podwan/balancer/document/remoter.jpg

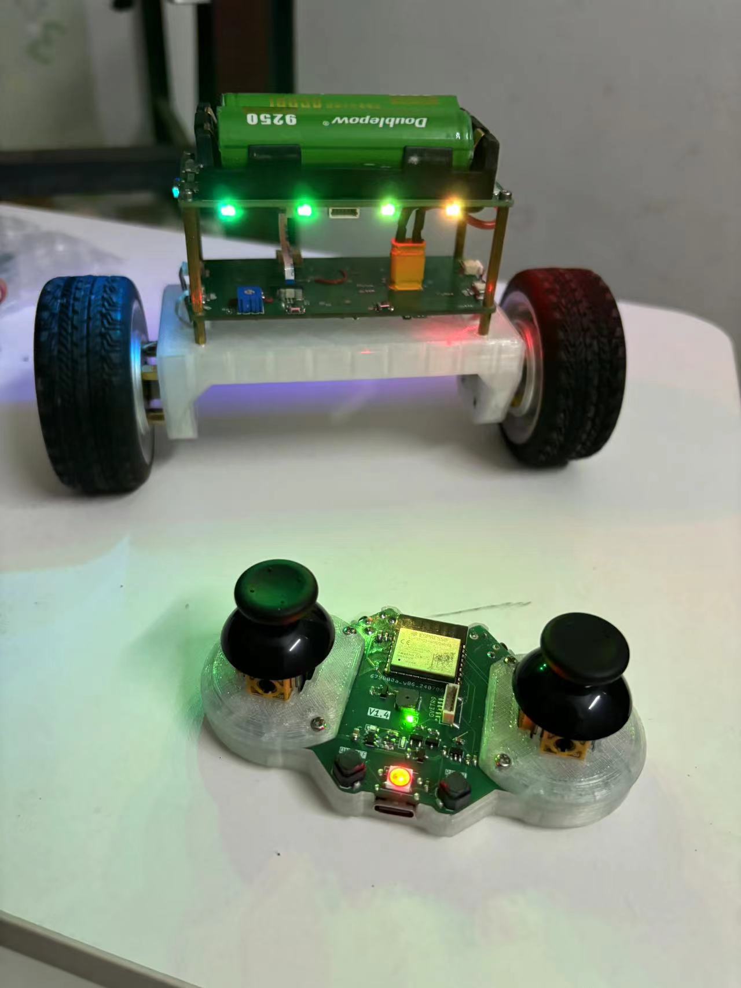
document/remoter.jpg
