podwan/balancer/document/balancer.jpg

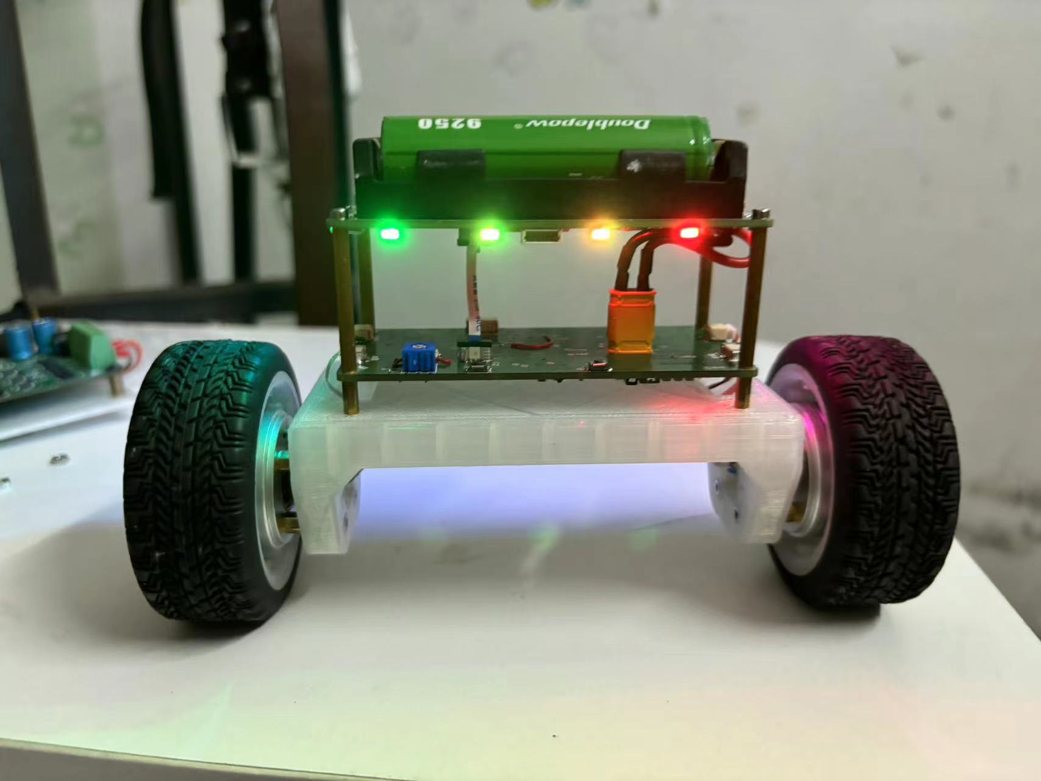
document/balancer.jpg
