podwan/balancer/document/stack.jpg

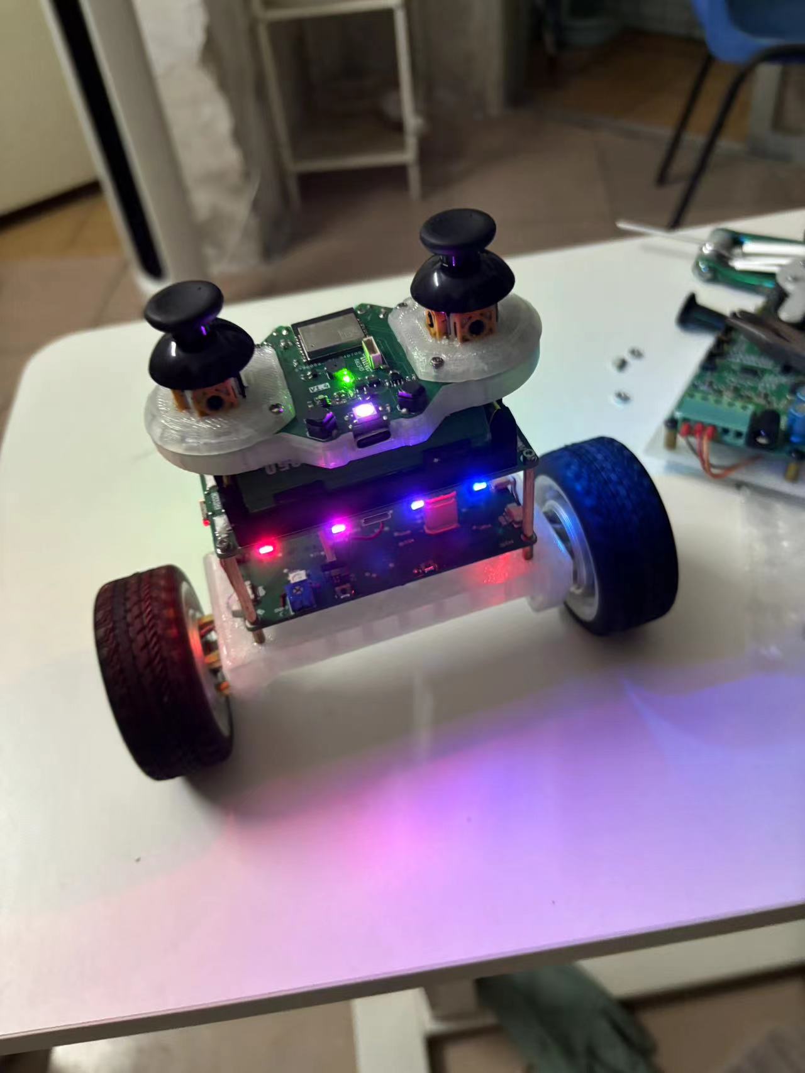
document/stack.jpg
