podwan/balancer/hardware/controller/3d/TS-1199A-B-B.stp

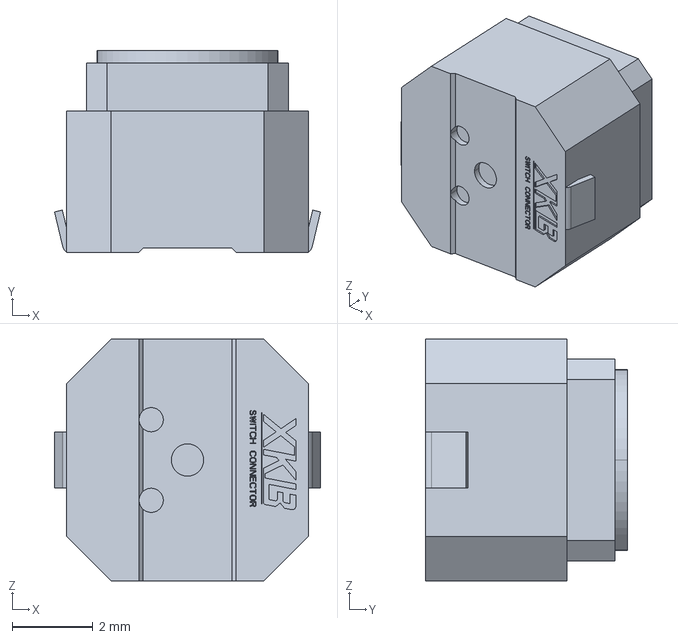
[picture p4: CAD file, 2024-05-17]
hardware/controller/3d/TS-1199A-B-B.stp
6.60 x 5.00 x 6.00 mm
