podwan/balancer/hardware/encoder/encoder_edge-Sketch.dxf

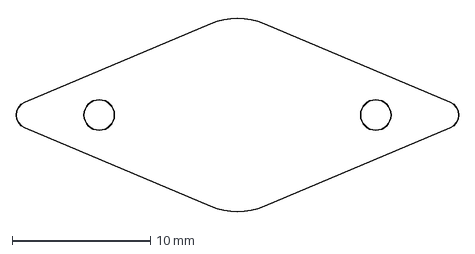
[picture p5: CAD file, 2024-05-17]
hardware/encoder/encoder_edge-Sketch.dxf
32.0 x 14.3 mm
