podwan/balancer/mechanic/wheel v10.stl

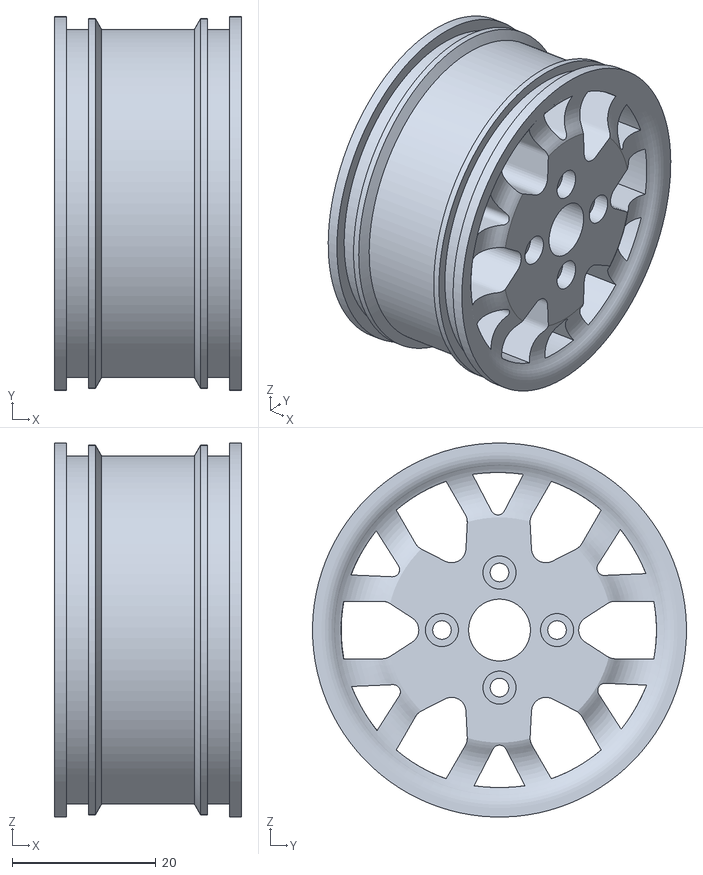
[picture p8: CAD file, 2024-06-01]
mechanic/wheel v10.stl
26.0 x 52.0 x 52.0
