podwan/balancer/hardware/controller/3d/TC-1102N-C-AS-B.stp

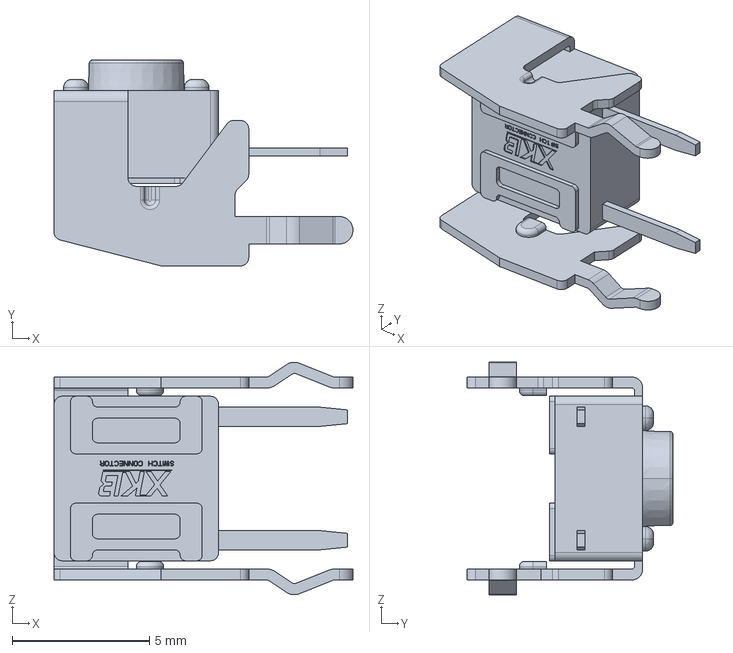
[picture p9: CAD file, 2024-05-17]
hardware/controller/3d/TC-1102N-C-AS-B.stp
10.9 x 7.50 x 8.48 mm
