podwan/balancer/hardware/encoder/encoder_edge.dxf

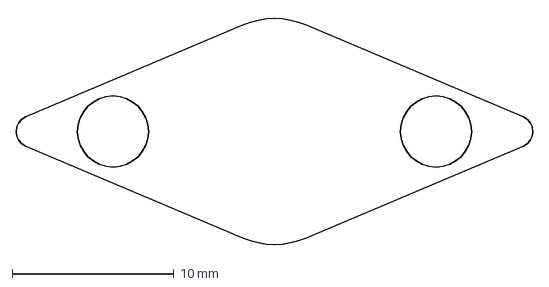
[picture p10: CAD file, 2024-05-17]
hardware/encoder/encoder_edge.dxf
32.0 x 14.3 mm
