podwan/balancer/mechanic/balancer v20.stl

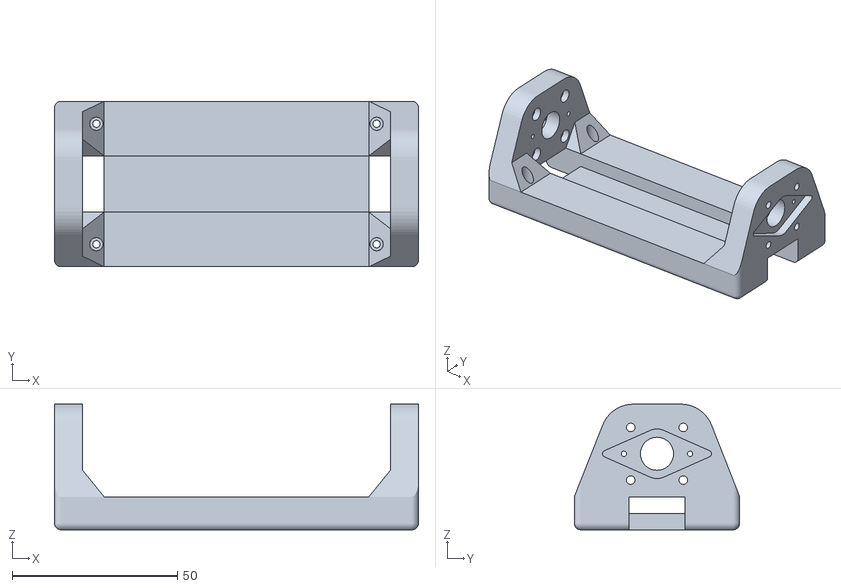
[picture p11: CAD file, 2024-06-01]
mechanic/balancer v20.stl
110.0 x 50.0 x 38.0
