podwan/balancer/mechanic/磁铁固定件.stl

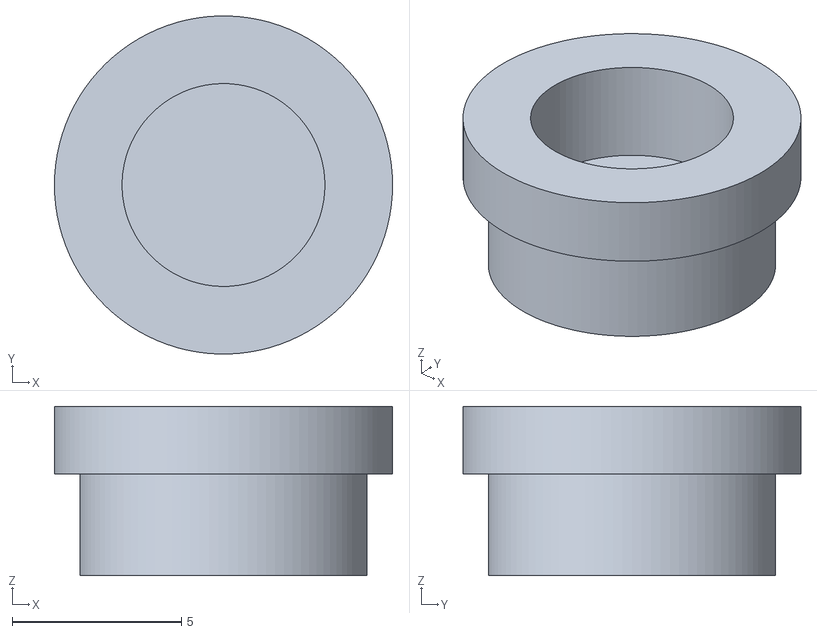
[picture p12: CAD file, 2024-05-17]
mechanic/磁铁固定件.stl
10.0 x 10.00 x 5.00
