podwan/balancer/hardware/motor/model/TPS61088RHLR.STEP

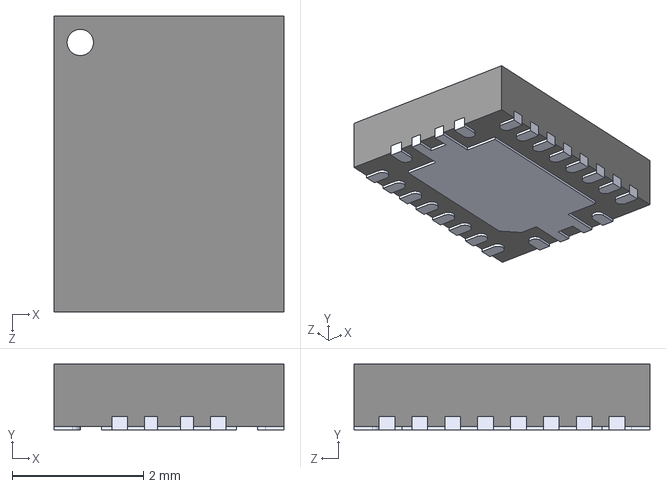
[picture p13: CAD file, 2023-12-19]
hardware/motor/model/TPS61088RHLR.STEP
3.50 x 1.00 x 4.50 mm
