podwan/balancer/(list of files, cad)

Other CAD files:
mechanic/encoder_edge.FCStd
