podwan/balancer/firmware/motorDriver/motorDriver.ioc

Mcu.UserName=STM32G431CBUx
PA1.Signal=ADC1_IN2
PA10.Signal=S_TIM1_CH3
PA11.GPIO_Label=TEST
PA11.Signal=GPIO_Output
PA13.Signal=SYS_JTMS-SWDIO
PA14.Signal=SYS_JTCK-SWCLK
PA2.Signal=USART2_TX
PA3.Signal=USART2_RX
PA4.GPIO_Label=SPI1_CS
PA4.Signal=GPIO_Output
PA5.Signal=SPI1_SCK
PA6.Signal=SPI1_MISO
PA7.Signal=SPI1_MOSI
PA8.Signal=S_TIM1_CH1
PA9.Signal=S_TIM1_CH2
PB0.Signal=SharedAnalog_PB0
PB1.Signal=SharedAnalog_PB1
PB10.Signal=USART3_TX
PB11.Signal=USART3_RX
PB12.Signal=ADC1_IN11
PB14.Signal=ADC1_IN5
PB15.Signal=ADC2_IN15
PB2.Signal=ADC2_IN12
PB3.GPIO_Label=NSS1
PB3.Signal=GPIO_Output
PB5.Signal=SPI3_MOSI
PB6.Signal=S_TIM8_CH1
PB8-BOOT0.Signal=S_TIM8_CH2
PB9.Signal=S_TIM8_CH3
PC10.Signal=SPI3_SCK
PC11.Signal=SPI3_MISO
PC13.Signal=GPIO_Input
PC14-OSC32_IN.GPIO_Label=KEY
PC14-OSC32_IN.Signal=GPIO_Input
PC4.GPIO_Label=NSS2
PC4.Signal=GPIO_Output
PF0-OSC_IN.Signal=RCC_OSC_IN
PF1-OSC_OUT.Signal=RCC_OSC_OUT
