podwan/balancer/firmware/motorDriver/FocLib/bldcMotor.c

#include "bldcMotor.h"
#include "math_utils.h"
#include "voltage.h"
#include "current.h"
#include "encoder.h"
#include "pid.h"
#include "lowpass_filter.h"
#include "focLib.h"

void goToZeroElecAngle(BldcMotor *motor)
{
    setTorque(motor, 0, OPEN_LOOP_TORQUE, 0);
    delay(700);
}
int alignSensor(BldcMotor *motor)
{
    // setTorque(motor, OPEN_LOOP_TORQUE, 0, _3PI_2);
    // delay(200);
    // encoderUpdate(&motor->magEncoder);
    // float start_angle = motor->magEncoder.fullAngle;
    // printLog("start_angle:%f\n", start_angle);
    for (int i = 0; i <= 500; i++)
    {
        float angle = _3PI_2 + _2PI * i / 500.0f;
        setTorque(motor, OPEN_LOOP_TORQUE, 0, angle);
        encoderUpdate(&motor->magEncoder);
        delay(2);
    }
    // encoderUpdate(&motor->magEncoder);

    float mid_angle = motor->magEncoder.fullAngle;
    printLog("mid_angle:%f\n", mid_angle);
    // move one electrical revolution backwards
    for (int i = 500; i >= 0; i--)
    {
        float angle = _3PI_2 + _2PI * i / 500.0f;
        setTorque(motor, OPEN_LOOP_TORQUE, 0, angle);
        encoderUpdate(&motor->magEncoder);
        delay(2);
    }
    // encoderUpdate(&motor->magEncoder);

    float end_angle = motor->magEncoder.fullAngle;
    printLog("end_angle:%f\n", end_angle);
    // setPhaseVoltage(0, 0, 0);
    delay(200);

    // determine the direction the sensor moved
    float moved = fabsf(mid_angle - end_angle);
    printLog("moved:%f\n", moved);
    if (moved < MIN_ANGLE_DETECT_MOVEMENT)
    { // minimum angle to detect movement
        printLog("Failed to notice movement\n");
        return 0; // failed calibration
    }
    else if (mid_angle < end_angle)
    {
        printLog("sensor_direction==CCW\n");
        motor->magEncoder.direction = CCW;
    }
    else
    {
        printLog("sensor_direction==CW\n");
        motor->magEncoder.direction = CW;
    }
    // check pole pair number
    bool pp_check_result = !(fabsf(moved * motor->pole_pairs - _2PI) > 0.5f); // 0.5f is arbitrary number it can be lower or higher!
    if (pp_check_result == false)
    {
        printLog("PP check: fail - estimated pp: %d\n", (int)(_2PI / moved));
    }
    else
    {
        printLog("PP check: OK!\n");
    }

    // align the electrical phases of the motor and sensor
    // set angle -90(270 = 3PI/2) degrees
    goToZeroElecAngle(motor);
    // read the sensor
    encoderUpdate(&motor->magEncoder);
    // get the current zero electric angle
    motor->zeroElectricAngleOffSet = 0;
    getElecAngle(motor);
    motor->zeroElectricAngleOffSet = motor->angle_el;
    // zero_electric_angle =  _normalizeAngle(_electricalAngle(sensor_direction*sensor->getAngle(), pole_pairs));

    // encoderUpdate(&motor->magEncoder);
    getElecAngle(motor);
    // motor->zeroElectricAngleOffSet = 0;
    // printLog("[zeroAngleOffset]:%f  [zeroAngle]:%f\r\n", motor->zeroElectricAngleOffSet, motor->angle_el);
    printLog("[zeroAngleOffset]:%f\n", motor->zeroElectricAngleOffSet);
    printLog("[zeroAngle]:%f\n", motor->angle_el);
    // // make sure the angle_el is about zero

    // delay(200);
}

void getElecAngle(BldcMotor *motor)
{
    motor->angle_el = _normalizeAngle(motor->pole_pairs * motor->magEncoder.shaftAngle - motor->zeroElectricAngleOffSet);
}

void foc(BldcMotor *motor, uint32_t adc_a, uint32_t adc_b)
{

    if (motor->state == MOTOR_CALIBRATE)
    {
        getCurrentOffsets(motor, adc_a, adc_b, 100);
        alignSensor(motor);
        motor->state = MOTOR_READY;
        motor->stopPwm();
    }
    else
    {

        float IqRef, velocityRef;
        float velocityErr, angleErr;

        getPhaseCurrents(motor, adc_a, adc_b);
        getABCurrents(motor);
        getDQCurrents(motor);
        motor->Iq = lpfOperator(&motor->IqFilter, motor->Iq);
        motor->Id = lpfOperator(&motor->IdFilter, motor->Id);
        encoderUpdate(&motor->magEncoder);
        motor->magEncoder.velocity = lpfOperator(&motor->velocityFilter, motor->magEncoder.velocity);

        getElecAngle(motor);

        if (motor->state == MOTOR_READY)
        {
        }
        else if (motor->state == MOTOR_START)
        {

            switch (motor->controlType)
            {
            case VELOCITY_OPEN_LOOP:
                // 用于验证setTorque（SVPWM马鞍波)函数、编码器测速（方向）及相电流采样（正弦波）的验证，
                // 避免长时间运行（发热）
                static float shaftAngle;
                motor->target = 50;
                shaftAngle = _normalizeAngle(shaftAngle + motor->target * motor->Ts);
                motor->angle_el = _electricalAngle(shaftAngle, motor->pole_pairs);
                motor->Uq = OPEN_LOOP_TORQUE;
                break;
            case TORQUE:

                if (motor->torqueType == VOLTAGE)
                {
                    // motor->target = UqMAX;
                    motor->Uq = motor->target;
                }
                else
                {
                    // motor->target = 0;
                    motor->Ud = pidOperator(&motor->pidId, 0 - motor->Id);
                    motor->Uq = pidOperator(&motor->pidIq, motor->target - motor->Iq);
                }
                break;

            case VELOCITY:
                if (motor->torqueType == VOLTAGE)
                {
                    // motor->target = 190;
                    velocityErr = motor->target - motor->magEncoder.velocity;
                    motor->Uq = pidOperator(&motor->velocityPID, velocityErr);
                }
                else
                {
                    velocityErr = motor->target - motor->magEncoder.velocity;
                    IqRef = pidOperator(&motor->velocityPID, velocityErr);

                    motor->Ud = pidOperator(&motor->pidId, 0 - motor->Id);
                    motor->Uq = pidOperator(&motor->pidIq, IqRef - motor->Iq);
                }
                break;

            case ANGLE:
                if (motor->torqueType == VOLTAGE)
                {
                    angleErr = motor->target - motor->magEncoder.fullAngle;
                    motor->Uq = pidOperator(&motor->anglePID, angleErr);
                }
                else
                {
                    angleErr = motor->target - motor->magEncoder.fullAngle;
                    velocityRef = pidOperator(&motor->anglePID, angleErr);
                    IqRef = pidOperator(&motor->velocityPID, velocityRef - motor->magEncoder.velocity);
                    // IqRef = pidOperator(&motor->anglePID, angleErr);
                    motor->Ud = pidOperator(&motor->pidId, 0 - motor->Id);
                    motor->Uq = pidOperator(&motor->pidIq, IqRef - motor->Iq);
                }
                break;
            }
            setTorque(motor, motor->Uq, motor->Ud, motor->angle_el);
        }
    }
}
