podwan/balancer/firmware/motorDriver/Core/Src/main.c

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
/* Includes ------------------------------------------------------------------*/
#include "main.h"
#include "adc.h"
#include "comp.h"
#include "dac.h"
#include "dma.h"
#include "spi.h"
#include "tim.h"
#include "usart.h"
#include "gpio.h"

/* USER CODE BEGIN Includes */
#include "comm.h"
#include "userMain.h"
#include "app.h"
/* USER CODE END Includes */


void SystemClock_Config(void);
/* USER CODE BEGIN 0 */
extern DMA_HandleTypeDef hdma_usart2_rx;
extern DMA_HandleTypeDef hdma_usart3_rx;
/* USER CODE END 0 */

/**
  * @brief  The application entry point.
  * @retval int
  */
int main(void)
{

  /* MCU Configuration--------------------------------------------------------*/

  /* Reset of all peripherals, Initializes the Flash interface and the Systick. */
  HAL_Init();

  /* Configure the system clock */
  SystemClock_Config();

  /* Initialize all configured peripherals */
  MX_GPIO_Init();
  MX_DMA_Init();
  MX_USART3_UART_Init();
  MX_ADC1_Init();
  MX_ADC2_Init();
  MX_TIM1_Init();
  MX_DAC3_Init();
  MX_SPI1_Init();
  MX_TIM8_Init();
  MX_SPI3_Init();
  MX_USART2_UART_Init();
  MX_COMP1_Init();
  MX_COMP4_Init();
  /* USER CODE BEGIN 2 */
  appInit();
#if 1
  HAL_UARTEx_ReceiveToIdle_DMA(&huart2, rxBuffer, sizeof(rxBuffer));
  __HAL_DMA_DISABLE_IT(&hdma_usart2_rx, DMA_IT_HT);
  HAL_UARTEx_ReceiveToIdle_DMA(&huart3, rxBuffer, sizeof(rxBuffer));
  __HAL_DMA_DISABLE_IT(&hdma_usart3_rx, DMA_IT_HT);
  // HAL_UARTEx_ReceiveToIdle_DMA(&huart3, rxBuffer, sizeof(rxBuffer));
  HAL_ADCEx_Calibration_Start(&hadc1, ADC_SINGLE_ENDED);
  HAL_ADCEx_Calibration_Start(&hadc2, ADC_SINGLE_ENDED);
  __HAL_ADC_CLEAR_FLAG(&hadc1, ADC_FLAG_JEOC);
  __HAL_ADC_CLEAR_FLAG(&hadc1, ADC_FLAG_EOC);
  __HAL_ADC_CLEAR_FLAG(&hadc2, ADC_FLAG_JEOC);

  HAL_DAC_SetValue(&hdac3, DAC_CHANNEL_1, DAC_ALIGN_12B_R, 2300);
  HAL_DAC_Start(&hdac3, DAC_CHANNEL_1);
  HAL_COMP_Start(&hcomp1);

  HAL_DAC_SetValue(&hdac3, DAC_CHANNEL_2, DAC_ALIGN_12B_R, 2300);
  HAL_DAC_Start(&hdac3, DAC_CHANNEL_2);
  HAL_COMP_Start(&hcomp4);

  HAL_ADCEx_InjectedStart_IT(&hadc1);
  HAL_ADCEx_InjectedStart(&hadc2);

  HAL_TIM_Base_Start(&htim8);
  HAL_TIM_PWM_Start(&htim8, TIM_CHANNEL_4);
  HAL_TIM_PWM_Start(&htim8, TIM_CHANNEL_1);
  HAL_TIM_PWM_Start(&htim8, TIM_CHANNEL_2);
  HAL_TIM_PWM_Start(&htim8, TIM_CHANNEL_3);

  HAL_TIM_Base_Start(&htim1);
  HAL_TIM_PWM_Start(&htim1, TIM_CHANNEL_4);
  HAL_TIM_PWM_Start(&htim1, TIM_CHANNEL_1);
  HAL_TIM_PWM_Start(&htim1, TIM_CHANNEL_2);
  HAL_TIM_PWM_Start(&htim1, TIM_CHANNEL_3);
#endif
  /* USER CODE END 2 */

  /* Infinite loop */
  /* USER CODE BEGIN WHILE */
  while (1)
  {
    /* USER CODE END WHILE */

    /* USER CODE BEGIN 3 */
    userMain();
  }
  /* USER CODE END 3 */
}

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
