podwan/balancer/firmware/espBat/BLE_client/BLE_client.ino

/**
 * A BLE client example that is rich in capabilities.
 * There is a lot new capabilities implemented.
 * author unknown
 * updated by chegewara
 */

#include "BLEDevice.h"
#include "driver/uart.h"
//#include "BLEScan.h"
HardwareSerial serial1(1);
// The remote service we wish to connect to.
static BLEUUID serviceUUID("6E400001-B5A3-F393-E0A9-E50E24DCCA9E");
// The characteristic of the remote service we are interested in.
static BLEUUID charUUID("6E400003-B5A3-F393-E0A9-E50E24DCCA9E");

static boolean doConnect = false;
static boolean connected = false;
static boolean doScan = false;
static BLERemoteCharacteristic* pRemoteCharacteristic;
static BLEAdvertisedDevice* myDevice;

static void notifyCallback(
  BLERemoteCharacteristic* pBLERemoteCharacteristic,
  uint8_t* pData,
  size_t length,
  bool isNotify) {
  Serial1.print("Notify callback for characteristic ");
  Serial1.print(pBLERemoteCharacteristic->getUUID().toString().c_str());
  Serial1.print(" of data length ");
  Serial1.println(length);
  Serial1.print("data: ");
  Serial1.write(pData, length);
  Serial1.println();
}

class MyClientCallback : public BLEClientCallbacks {
  void onConnect(BLEClient* pclient) {
  }

  void onDisconnect(BLEClient* pclient) {
    connected = false;
    Serial1.println("onDisconnect");
  }
};

bool connectToServer() {
  Serial1.print("Forming a connection to ");
  Serial1.println(myDevice->getAddress().toString().c_str());

  BLEClient* pClient = BLEDevice::createClient();
  Serial1.println(" - Created client");

  pClient->setClientCallbacks(new MyClientCallback());

  // Connect to the remove BLE Server.
  pClient->connect(myDevice);  // if you pass BLEAdvertisedDevice instead of address, it will be recognized type of peer device address (public or private)
  Serial1.println(" - Connected to server");
  pClient->setMTU(517);  //set client to request maximum MTU from server (default is 23 otherwise)

  // Obtain a reference to the service we are after in the remote BLE server.
  BLERemoteService* pRemoteService = pClient->getService(serviceUUID);
  if (pRemoteService == nullptr) {
    Serial1.print("Failed to find our service UUID: ");
    Serial1.println(serviceUUID.toString().c_str());
    pClient->disconnect();
    return false;
  }
  Serial1.println(" - Found our service");


  // Obtain a reference to the characteristic in the service of the remote BLE server.
  pRemoteCharacteristic = pRemoteService->getCharacteristic(charUUID);
  if (pRemoteCharacteristic == nullptr) {
    Serial1.print("Failed to find our characteristic UUID: ");
    Serial1.println(charUUID.toString().c_str());
    pClient->disconnect();
    return false;
  }
  Serial1.println(" - Found our characteristic");

  // Read the value of the characteristic.pRemoteCharacteristic
  if (pRemoteCharacteristic->canRead()) {
    std::string value = pRemoteCharacteristic->readValue();
    Serial1.print("The characteristic value was: ");
    Serial1.println(value.c_str());
  }

  if (pRemoteCharacteristic->canNotify())
    pRemoteCharacteristic->registerForNotify(notifyCallback);

  connected = true;
  return true;
}
/**
 * Scan for BLE servers and find the first one that advertises the service we are looking for.
 */
class MyAdvertisedDeviceCallbacks : public BLEAdvertisedDeviceCallbacks {
  /**
   * Called for each advertising BLE server.
   */
  void onResult(BLEAdvertisedDevice advertisedDevice) {
    Serial1.print("BLE Advertised Device found: ");
    Serial1.println(advertisedDevice.toString().c_str());

    // We have found a device, let us now see if it contains the service we are looking for.
    if (advertisedDevice.haveServiceUUID() && advertisedDevice.isAdvertisingService(serviceUUID)) {

      BLEDevice::getScan()->stop();
      myDevice = new BLEAdvertisedDevice(advertisedDevice);
      doConnect = true;
      doScan = true;

    }  // Found our server
  }    // onResult
};     // MyAdvertisedDeviceCallbacks


void setup() {
  serial1.begin(115200, SERIAL_8N1, 20, 21);
  Serial1.println("Starting Arduino BLE Client application...");
  BLEDevice::init("");

  // Retrieve a Scanner and set the callback we want to use to be informed when we
  // have detected a new device.  Specify that we want active scanning and start the
  // scan to run for 5 seconds.
  BLEScan* pBLEScan = BLEDevice::getScan();
  pBLEScan->setAdvertisedDeviceCallbacks(new MyAdvertisedDeviceCallbacks());
  pBLEScan->setInterval(1349);
  pBLEScan->setWindow(449);
  pBLEScan->setActiveScan(true);
  pBLEScan->start(5, false);
}  // End of setup.


// This is the Arduino main loop function.
void loop() {

  // If the flag "doConnect" is true then we have scanned for and found the desired
  // BLE Server with which we wish to connect.  Now we connect to it.  Once we are
  // connected we set the connected flag to be true.
  if (doConnect == true) {
    if (connectToServer()) {
      Serial1.println("We are now connected to the BLE Server.");
    } else {
      Serial1.println("We have failed to connect to the server; there is nothin more we will do.");
    }
    doConnect = false;
  }

  // If we are connected to a peer BLE Server, update the characteristic each time we are reached
  // with the current time since boot.
  if (connected) {
    String newValue = "Time since boot: " + String(millis() / 1000);
    Serial1.println("Setting new characteristic value to \"" + newValue + "\"");

    // Set the characteristic's value to be the array of bytes that is actually a string.
    pRemoteCharacteristic->writeValue(newValue.c_str(), newValue.length());
  } else if (doScan) {
    BLEDevice::getScan()->start(0);  // this is just example to start scan after disconnect, most likely there is better way to do it in arduino
  }

  delay(1000);  // Delay a second between loops.
}  // End of loop
