podwan/balancer/firmware/motorDriver/User/pwm.c

#include "pwm.h"

 void startPwm1()
{
    HAL_TIM_PWM_Start(&htim8, TIM_CHANNEL_1);
    HAL_TIM_PWM_Start(&htim8, TIM_CHANNEL_2);
    HAL_TIM_PWM_Start(&htim8, TIM_CHANNEL_3);

}
 void stopPwm1()
{
    HAL_TIM_PWM_Stop(&htim8, TIM_CHANNEL_1);
    HAL_TIM_PWM_Stop(&htim8, TIM_CHANNEL_2);
    HAL_TIM_PWM_Stop(&htim8, TIM_CHANNEL_3);

}
 void updatePwm1(unsigned short int a, unsigned short int b, unsigned short int c)
{
    TIM8->CCR1 = a;
    TIM8->CCR2 = b;
    TIM8->CCR3 = c;
}

 void startPwm2()
{
    HAL_TIM_PWM_Start(&htim1, TIM_CHANNEL_1);
    HAL_TIM_PWM_Start(&htim1, TIM_CHANNEL_2);
    HAL_TIM_PWM_Start(&htim1, TIM_CHANNEL_3);
 
}
 void stopPwm2()
{
    HAL_TIM_PWM_Stop(&htim1, TIM_CHANNEL_1);
    HAL_TIM_PWM_Stop(&htim1, TIM_CHANNEL_2);
    HAL_TIM_PWM_Stop(&htim1, TIM_CHANNEL_3);
 
}

 void updatePwm2(unsigned short int a, unsigned short int b, unsigned short int c)
{
    TIM1->CCR1 = c;
    TIM1->CCR2 = b;
    TIM1->CCR3 = a;
}
