podwan/balancer/firmware/motorDriver/User/mpu6500.h

#ifndef BSP_SPI_H
#define BSP_SPI_H
#include "userMain.h"

uint8_t mpu_write_byte(uint8_t const reg, uint8_t const data);
void task(void);
// MPU6500初始数据结构体
typedef struct
{
    int16_t ax;
    int16_t ay;
    int16_t az;

    int16_t mx;
    int16_t my;
    int16_t mz;

    int16_t temp;

    int16_t gx;
    int16_t gy;
    int16_t gz;

    int16_t ax_offset;
    int16_t ay_offset;
    int16_t az_offset;

    int16_t gx_offset;
    int16_t gy_offset;
    int16_t gz_offset;
} mpu_data_t;

// 惯性测量单元数据结构体
typedef struct
{
    int16_t ax;
    int16_t ay;
    int16_t az;

    int16_t mx;
    int16_t my;
    int16_t mz;

    float temp;

    float wx; /*!< omiga, +- 2000dps => +-32768  so gx/16.384/57.3 =	rad/s */
    float wy;
    float wz;

    float vx;
    float vy;
    float vz;

    float rol;
    float pit;
    float yaw;
} imu_t;

extern mpu_data_t mpu_data;
extern imu_t imu;

// mpu地址
#define MPU6500_SELF_TEST_XG (0x00)
#define MPU6500_SELF_TEST_YG (0x01)
#define MPU6500_SELF_TEST_ZG (0x02)
#define MPU6500_SELF_TEST_XA (0x0D)
#define MPU6500_SELF_TEST_YA (0x0E)
#define MPU6500_SELF_TEST_ZA (0x0F)
#define MPU6500_XG_OFFSET_H (0x13)
#define MPU6500_XG_OFFSET_L (0x14)
#define MPU6500_YG_OFFSET_H (0x15)
#define MPU6500_YG_OFFSET_L (0x16)
#define MPU6500_ZG_OFFSET_H (0x17)
#define MPU6500_ZG_OFFSET_L (0x18)
#define MPU6500_SMPLRT_DIV (0x19)
#define MPU6500_CONFIG (0x1A)
#define MPU6500_GYRO_CONFIG (0x1B)
#define MPU6500_ACCEL_CONFIG (0x1C)
#define MPU6500_ACCEL_CONFIG_2 (0x1D)
#define MPU6500_LP_ACCEL_ODR (0x1E)
#define MPU6500_MOT_THR (0x1F)
#define MPU6500_FIFO_EN (0x23)
#define MPU6500_I2C_MST_CTRL (0x24)
#define MPU6500_I2C_SLV0_ADDR (0x25)
#define MPU6500_I2C_SLV0_REG (0x26)
#define MPU6500_I2C_SLV0_CTRL (0x27)
#define MPU6500_I2C_SLV1_ADDR (0x28)
#define MPU6500_I2C_SLV1_REG (0x29)
#define MPU6500_I2C_SLV1_CTRL (0x2A)
#define MPU6500_I2C_SLV2_ADDR (0x2B)
#define MPU6500_I2C_SLV2_REG (0x2C)
#define MPU6500_I2C_SLV2_CTRL (0x2D)
#define MPU6500_I2C_SLV3_ADDR (0x2E)
#define MPU6500_I2C_SLV3_REG (0x2F)
#define MPU6500_I2C_SLV3_CTRL (0x30)
#define MPU6500_I2C_SLV4_ADDR (0x31)
#define MPU6500_I2C_SLV4_REG (0x32)
#define MPU6500_I2C_SLV4_DO (0x33)
#define MPU6500_I2C_SLV4_CTRL (0x34)
#define MPU6500_I2C_SLV4_DI (0x35)
#define MPU6500_I2C_MST_STATUS (0x36)
#define MPU6500_INT_PIN_CFG (0x37)
#define MPU6500_INT_ENABLE (0x38)
#define MPU6500_INT_STATUS (0x3A)
#define MPU6500_ACCEL_XOUT_H (0x3B)
#define MPU6500_ACCEL_XOUT_L (0x3C)
#define MPU6500_ACCEL_YOUT_H (0x3D)
#define MPU6500_ACCEL_YOUT_L (0x3E)
#define MPU6500_ACCEL_ZOUT_H (0x3F)
#define MPU6500_ACCEL_ZOUT_L (0x40)
#define MPU6500_TEMP_OUT_H (0x41)
#define MPU6500_TEMP_OUT_L (0x42)
#define MPU6500_GYRO_XOUT_H (0x43)
#define MPU6500_GYRO_XOUT_L (0x44)
#define MPU6500_GYRO_YOUT_H (0x45)
#define MPU6500_GYRO_YOUT_L (0x46)
#define MPU6500_GYRO_ZOUT_H (0x47)
#define MPU6500_GYRO_ZOUT_L (0x48)
#define MPU6500_EXT_SENS_DATA_00 (0x49)
#define MPU6500_EXT_SENS_DATA_01 (0x4A)
#define MPU6500_EXT_SENS_DATA_02 (0x4B)
#define MPU6500_EXT_SENS_DATA_03 (0x4C)
#define MPU6500_EXT_SENS_DATA_04 (0x4D)
#define MPU6500_EXT_SENS_DATA_05 (0x4E)
#define MPU6500_EXT_SENS_DATA_06 (0x4F)
#define MPU6500_EXT_SENS_DATA_07 (0x50)
#define MPU6500_EXT_SENS_DATA_08 (0x51)
#define MPU6500_EXT_SENS_DATA_09 (0x52)
#define MPU6500_EXT_SENS_DATA_10 (0x53)
#define MPU6500_EXT_SENS_DATA_11 (0x54)
#define MPU6500_EXT_SENS_DATA_12 (0x55)
#define MPU6500_EXT_SENS_DATA_13 (0x56)
#define MPU6500_EXT_SENS_DATA_14 (0x57)
#define MPU6500_EXT_SENS_DATA_15 (0x58)
#define MPU6500_EXT_SENS_DATA_16 (0x59)
#define MPU6500_EXT_SENS_DATA_17 (0x5A)
#define MPU6500_EXT_SENS_DATA_18 (0x5B)
#define MPU6500_EXT_SENS_DATA_19 (0x5C)
#define MPU6500_EXT_SENS_DATA_20 (0x5D)
#define MPU6500_EXT_SENS_DATA_21 (0x5E)
#define MPU6500_EXT_SENS_DATA_22 (0x5F)
#define MPU6500_EXT_SENS_DATA_23 (0x60)
#define MPU6500_I2C_SLV0_DO (0x63)
#define MPU6500_I2C_SLV1_DO (0x64)
#define MPU6500_I2C_SLV2_DO (0x65)
#define MPU6500_I2C_SLV3_DO (0x66)
#define MPU6500_I2C_MST_DELAY_CTRL (0x67)
#define MPU6500_SIGNAL_PATH_RESET (0x68)
#define MPU6500_MOT_DETECT_CTRL (0x69)
#define MPU6500_USER_CTRL (0x6A)
#define MPU6500_PWR_MGMT_1 (0x6B)
#define MPU6500_PWR_MGMT_2 (0x6C)
#define MPU6500_FIFO_COUNTH (0x72)
#define MPU6500_FIFO_COUNTL (0x73)
#define MPU6500_FIFO_R_W (0x74)
#define MPU6500_WHO_AM_I (0x75) // mpu6500 id = 0x70
#define MPU6500_XA_OFFSET_H (0x77)
#define MPU6500_XA_OFFSET_L (0x78)
#define MPU6500_YA_OFFSET_H (0x7A)
#define MPU6500_YA_OFFSET_L (0x7B)
#define MPU6500_ZA_OFFSET_H (0x7D)
#define MPU6500_ZA_OFFSET_L (0x7E)

#define MPU6050_ID (0x68)
#define MPU6500_ID (0x75) // mpu6500 id = 0x70

#define MPU_HSPI hspi1 // SPI句柄定义
#define MPU_NSS_LOW HAL_GPIO_WritePin(SPI1_CS_GPIO_Port, SPI1_CS_Pin, GPIO_PIN_RESET)
#define MPU_NSS_HIGH HAL_GPIO_WritePin(SPI1_CS_GPIO_Port, SPI1_CS_Pin, GPIO_PIN_SET)

#define Kp 2.0f  /*                                \
                  * 比例增益                   \
                  * 融合加速度计和磁强计 \
                  */
#define Ki 0.01f /*                       \
                  * 积分增益          \
                  * 陀螺仪偏差收敛 \
                  */

bool IMU_Init(void);
void init_quaternion(void);
void mpu_get_data(void);
void imu_ahrs_update(void);
void imu_attitude_update(void);
void mpu_offset_call(void);
uint8_t mpu_read_byte(uint8_t const reg);
#endif
