podwan/balancer/firmware/controller/ble.cpp

#include <BLEServer.h>
#include <BLEUtils.h>
#include <BLE2902.h>
#include "BLEDevice.h"
#include "driver/uart.h"
#include "ble.h"
#include "joystick.h"
extern bool toSendCMD;
extern DataPackage dataPackage;
unsigned char bleBuff[10];
extern HardwareSerial serial1;

bool deviceConnected = false;
extern char leftY, leftX, rightY, rightX;

// Humidity Characteristic and Descriptor
BLECharacteristic txCharacteristics("ca73b3ba-39f6-4ab3-91ae-186dc9577d99", BLECharacteristic::PROPERTY_NOTIFY);
BLEDescriptor txDescriptor(BLEUUID((uint16_t)0x2903));

// Setup callbacks onConnect and onDisconnect
class MyServerCallbacks : public BLEServerCallbacks {
  void onConnect(BLEServer *pServer) {
    deviceConnected = true;
  };
  void onDisconnect(BLEServer *pServer) {
    deviceConnected = false;
    pServer->getAdvertising()->start();
  }
};

BLECharacteristic *pTxCharacteristic;
BLEServer *pServer;
BLEService *bmeService;
void bleInit() {
  // Create the BLE Device
  BLEDevice::init(bleServerName);

  // Create the BLE Server
  pServer = BLEDevice::createServer();
  pServer->setCallbacks(new MyServerCallbacks());

  // Create the BLE Service
  bmeService = pServer->createService(SERVICE_UUID);

  bmeService->addCharacteristic(&txCharacteristics);
  txDescriptor.setValue("joyStick");
  txCharacteristics.addDescriptor(new BLE2902());

  // Start the service
  bmeService->start();

  // Start advertising
  BLEAdvertising *pAdvertising = BLEDevice::getAdvertising();
  pAdvertising->addServiceUUID(SERVICE_UUID);
  pServer->getAdvertising()->start();
  serial1.println("Waiting a client connection to notify...");
}

void blePolling() {
  if (deviceConnected) {
    // serial1.printf("connected\n");

    if (toSendCMD) {
      serial1.printf("send %s", bleBuff);
      txCharacteristics.setValue((uint8_t *)&bleBuff, sizeof(bleBuff));
      txCharacteristics.notify();
      toSendCMD = 0;
    } else {
      dataPackage.firstByte = 'J';
      txCharacteristics.setValue((uint8_t *)&dataPackage, sizeof(dataPackage));
      txCharacteristics.notify();
    }

    // serial1.printf("send data length%d\n", sizeof(dataPackage));
  } else {

    pServer->getAdvertising()->start();
  }
}
