podwan/balancer/(commit log)

2023-12-03 hardware init
    [bat_rf.kicad_pcb, bat_rf.kicad_sch]
2023-12-03 hardware update
    [bat_rf.kicad_sch]
2023-12-03 hardware edit
    [bat_rf.kicad_sch]
2023-12-03 文件整理
    [2808磁铁套.STL, 2808车架.STL, 请先查阅本文档.xlsx, 车轮2808.STL, 防护件1.STL, 防护件2.STL]
2023-12-04 加入充电电路
    [2808磁铁套.STL, 2808车架.STL, BOM_18650_Recharger_18650_recharger_2023-12-04.xlsx, BOM_AT32_Balance_Eval_V1.3_at32_balance_eval_v1.3_2023-12-04.xlsx, BOM_BAT_ESP32_Eval_V1.1_bat_esp32_eval_v1.1_2023-12-04.xlsx, BOM_MA732_Eval_A_V1.1_ma732_eval_a_v1.1_2023-12-04.xlsx, USB4515-GF-A--3DModel-STEP-269445.STEP, bat_rf.kicad_pcb]
2023-12-16 esp32 sch update
    [bat_rf.kicad_pcb, bat_rf.kicad_sch, edge.FCStd]
2023-12-17 rfBat PCB sent to manufacturing
    [bat_rf-B_Cu.gbr, bat_rf-B_Mask.gbr, bat_rf-B_Paste.gbr, bat_rf-B_Silkscreen.gbr, bat_rf-Edge_Cuts.gbr, bat_rf-F_Cu.gbr, bat_rf-F_Mask.gbr, bat_rf-F_Paste.gbr]
2023-12-19 espBat update
    [bat_rf.kicad_sch]
2023-12-22 bldcDriver sch update
    [bldcDriver.kicad_sch]
2023-12-31 driver sch update
    [bldcDriver.kicad_sch, untitled.kicad_sch]
2024-01-01 batRf to v1.1
    [bat_rf-B_Cu.gbr, bat_rf-B_Mask.gbr, bat_rf-B_Paste.gbr, bat_rf-B_Silkscreen.gbr, bat_rf-Edge_Cuts.gbr, bat_rf-F_Cu.gbr, bat_rf-F_Mask.gbr, bat_rf-F_Paste.gbr]
2024-01-06 paused for preparing foc with sensor
2024-02-19 更换充电芯片
2024-03-01 更新rfBat PCB
    [bat_rf-B_Cu.gbr, bat_rf-B_Mask.gbr, bat_rf-B_Paste.gbr, bat_rf-B_Silkscreen.gbr, bat_rf-Edge_Cuts.gbr, bat_rf-F_Cu.gbr, bat_rf-F_Mask.gbr, bat_rf-F_Paste.gbr]
2024-03-24 update espBat
    [bat_rf.kicad_pcb, bat_rf.kicad_sch, bldcDriver.kicad_pcb]
2024-03-25 update rfBat
    [bat_rf.kicad_pcb, bat_rf.kicad_sch]
2024-03-26 “update”
    [bat_rf.kicad_sch]
2024-03-27 update rfBat pcb
    [USB4515-GF-A--3DModel-STEP-269445.STEP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]
2024-03-28 rfBat ready to manufacture
    [bat_rf-B_Cu.gbr, bat_rf-B_Mask.gbr, bat_rf-B_Paste.gbr, bat_rf-B_Silkscreen.gbr, bat_rf-Edge_Cuts.gbr, bat_rf-F_Cu.gbr, bat_rf-F_Mask.gbr, bat_rf-F_Paste.gbr]
2024-04-03 motor sch update
    [2808磁铁套.STL, 2808车架.STL, BOM_18650_Recharger_18650_recharger_2023-12-04.xlsx, BOM_AT32_Balance_Eval_V1.3_at32_balance_eval_v1.3_2023-12-04.xlsx, BOM_BAT_ESP32_Eval_V1.1_bat_esp32_eval_v1.1_2023-12-04.xlsx, BOM_MA732_Eval_A_V1.1_ma732_eval_a_v1.1_2023-12-04.xlsx, bat_rf.kicad_sch, bldcDriver.kicad_sch]
2024-04-04 motorDriver sch update
    [bldcDriver.kicad_pcb, bldcDriver.kicad_sch, untitled.kicad_sch]
2024-04-05 update motorDriver sch
    [bldcDriver.kicad_sch, untitled.kicad_sch]
2024-04-06 update driver pcb
    [bldcDriver.kicad_pcb, bldcDriver.kicad_sch, untitled.kicad_sch]
2024-04-07 update pcbs
    [bat_rf-B_Cu.gbr, bat_rf-B_Mask.gbr, bat_rf-B_Paste.gbr, bat_rf-B_Silkscreen.gbr, bat_rf-Edge_Cuts.gbr, bat_rf-F_Cu.gbr, bat_rf-F_Mask.gbr, bat_rf-F_Paste.gbr]
2024-04-08 motorDriver pcb update
    [biplane.obj, bldcDriver.kicad_pcb, untitled.kicad_sch]
2024-04-08 update motorDriver pcb
    [bldcDriver.kicad_pcb, bldcDriver.kicad_sch, untitled.kicad_sch]
2024-04-09 update driver pcn
    [bldcDriver.kicad_pcb, untitled.kicad_sch]
2024-04-20 update mechanic
    [TPS61088RHLR.STEP, bat_rf.kicad_pcb, bldcDriver.kicad_pcb, bldcDriver.kicad_sch, body.stl, untitled.kicad_sch, wheel.FCStd, wheel.stl]
2024-04-21 update rfBat firmware
    [edge.FCStd, wheel.FCStd, wheel.stl, 底壳.STL, 迷你遥控器.dxf, 顶壳4mm厚（基础版可选安装）.STL]
2024-04-22 update controller sch
    [TPS61088RHLR.STEP, bldcDriver.kicad_pcb, bldcDriver.kicad_sch, untitled.kicad_sch]
2024-04-22 update controller pcb
    [controller.kicad_pcb, controller.kicad_sch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]
2024-04-23 update body
    [bat_rf.kicad_pcb, bldcDriver.kicad_pcb, encoder.kicad_pcb, encoder.kicad_sch, encoder_edge-Sketch.dxf, encoder_edge.FCStd, encoder_edge.dxf]
2024-04-28 update motor pcb
    [bldcDriver.kicad_pcb, bldcDriver.kicad_sch, controller.kicad_pcb, controller.kicad_sch, untitled.kicad_sch]
2024-05-10 update pcb
    [bat_rf.kicad_sch, bldcDriver.kicad_pcb, untitled.kicad_sch]
2024-05-12 update controller firmware
    [bat_rf.kicad_sch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]
2024-05-14 update motor firmware
2024-05-27 update pcn
    [TPS61088RHLR.STEP, bat_rf.kicad_pcb, bat_rf.kicad_sch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]
2024-06-10 update ibom
    [bldcDriver-B_Cu.gbr, bldcDriver-B_Mask.gbr, bldcDriver-B_Paste.gbr, bldcDriver-B_Silkscreen.gbr, bldcDriver-Edge_Cuts.gbr, bldcDriver-F_Cu.gbr, bldcDriver-F_Mask.gbr, bldcDriver-F_Paste.gbr]
2024-06-10 update espBat firmware
    [自平衡莱洛三角形V3_BOM_最终版20231031.xlsx]
2024-06-11 udpate controller pcb
    [2808磁铁套.STL, 2808车架.STL, TPS61088RHLR.STEP, balancerBody.stl, bat_rf.kicad_pcb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]
2024-06-15 upate motor firmware
2024-06-23 update motor
    [bldcDriver-B_Cu.gbr, bldcDriver-B_Mask.gbr, bldcDriver-B_Paste.gbr, bldcDriver-B_Silkscreen.gbr, bldcDriver-Edge_Cuts.gbr, bldcDriver-F_Cu.gbr, bldcDriver-F_Mask.gbr, bldcDriver-F_Paste.gbr]
2024-06-25 update firmware
    [bldcDriver.csv]
2024-07-04 update controller
    [controller.kicad_pcb, controller.kicad_sch]
2024-07-07 update bat PCB
    [bat_rf.kicad_pcb]
2024-07-13 udpate ble firmware
    [bldcDriver.kicad_pcb, bldcDriver.kicad_sch]
2024-07-20 udpate motor firmware
    [bldcDriver.kicad_pcb, bldcDriver.kicad_sch]
2024-07-23 电压初步性能
2024-07-24 电压性能版
